mikolajcebula/chwytak-robot/Raport.pdf

## Projekt chwytaka do robota FANUK M-10iA

Mikołaj Cebula
Numer albumu 304486

prowadzący
Grzegorz Kamiński

6 grudnia 2021

## Spis treści

1 Wstęp | 2
2 Kinematyka mechanizmu | 2
3 Wyznaczenie siły chwytu chwytaka | 4
4 Dobór siłownika | 5
5 Dobór śrub pasowych | 8
6 Dobór łożysk | 13
7 Podsumowanie | 15

1

2 KINEMATYKA MECHANIZMU

## 1 Wstęp

Projekt polegał na zaprojektowaniu oraz wykonanie dokumentacji technicznej chwytaka do robota FANUC M-10iA. Ma on za zadanie przenoszenie okrągłych elementów o średnicy od 55 do 77 mm. Dodatkowo zakłądam, że ciężar przedmiotu nie przekroczy 43 N.

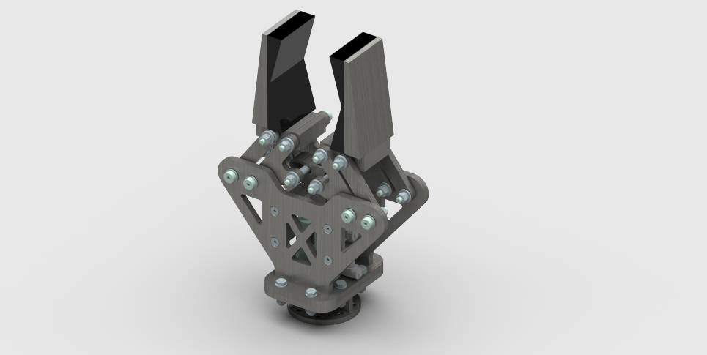
[picture p1: figure]

Rysunek 1: Wizualizacja gotowego projektu.

Jako napęd zastosowany zostanie siłownik pneulatyczny, którgo parametry zostaną dobrane w dalszym etapie projektu.

## 2 Kinematyka mechanizmu

Pierwszym krokiem w realizacji było oblicznie liczby stopni swobody. Z uwagi na ruch chwytaka w jednej płaszczyźnie, skorzystano z uproszczonego wzoru Grublera [1]:

w = 3 ∗ n − p4 − 2 ∗ p5

n - liczba elementów, p4 - liczba par 4 klasy, p5- liczba par 5 klasy

Poniższe zdjęcię ostatecznego modelu prezentuje liczbę elementów oraz par kinematycznych.

2

2 KINEMATYKA MECHANIZMU

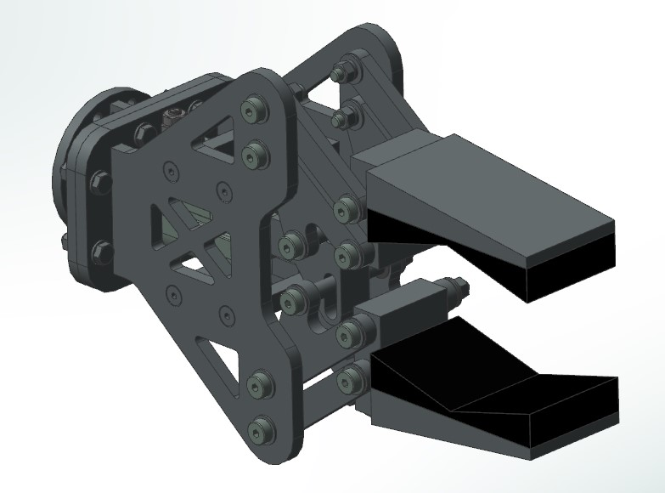
[picture p2: figure]

Rysunek 2: Wizualizacja liczby elementów i par kinematycznych modelu.

Układ kinematyczny składa się z:

| popychacza
| 4 cięgien L
| 4 cięgien prostych
| 2 chwytników

Więc układ złożony jest z 11 ogniw. Nie posiada par kinematycznych 4 klasy, natomiast składa się z 16 par kinematycznych 5 klasy (4 pary postępowe i 12 obrotowych).

w = 3 ∗ 11 − 2 ∗ 16 = 1

Z obliczeń wynika, że mechanizm chwytaka ma 1 stopień swobody.

3

3 WYZNACZENIE SIŁY CHWYTU CHWYTAKA

## 3 Wyznaczenie siły chwytu chwytaka

Siłę chwytu można wyznacza się za pomocą wzoru:

Fch = 2 ∗ N ∗ cos(90◦ − γ)

Gdzie poszczególne oznaczenia przedstawiono na schemacie:

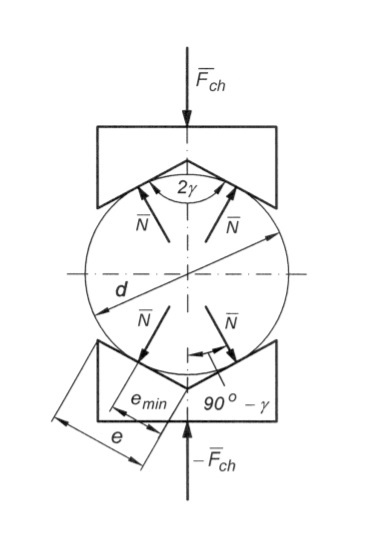
[picture p3: figure]

Rysunek 3: Rozkład sił normalnyh podczas chwytania obiektu.

4

4 DOBÓR SIŁOWNIKA

Współczynnik tarcia między metalem, a gumą wynosi η = 1 [2]. Natomiast współczynnik przeciążenia chwytaka przyjęto n=2. Z powodu okrągłego kształty przenoszonego przedmioty kąt pomiędzy gumowymi okładzinami wynosi γ = 150◦
T = N ∗ η = Fc ∗ η = Fc

Fch =

Fc ∗ n ∗ cos(90◦ − γ)
2 ∗ η

= Fc ∗ cos(90◦ − γ)

Fch = 41, 5N

## 4 Dobór siłownika

W tym kroku wyliczono siłę potrzeną do zamknięcia chwytaka. Na jej podstawie, dobrano odpowiedni siłownik z katalogu firmy Festo [3]. Aby wykonać to zadanie należy sprowadzić mechanizm do niżej pokazanego schematu, wyliczyć reakcje oraz siłę siłownika w zakresie pracy chwytaka [1].

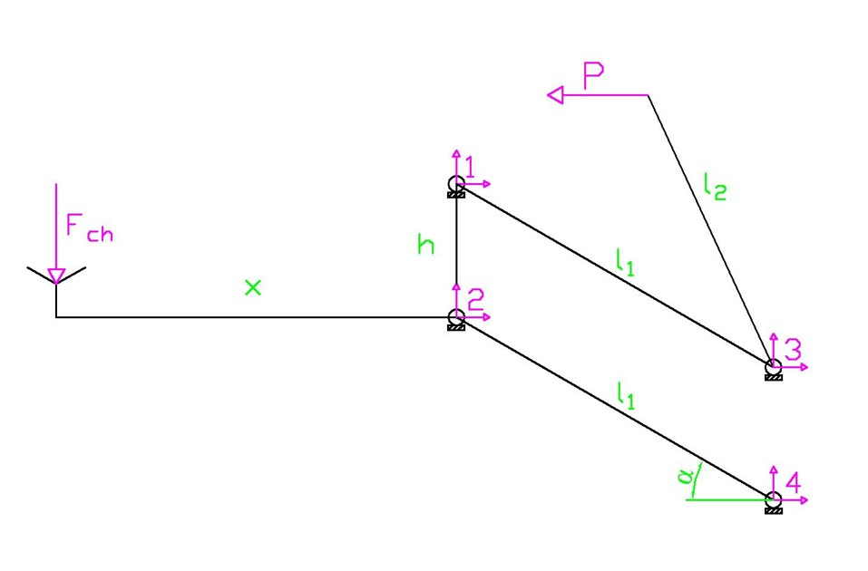
[picture p4: figure]

Rysunek 4: Schemat kinematyczny

5

4 DOBÓR SIŁOWNIKA

Na podstawie powyższego schematu, można zapisać następujące równania:

F1x + F2x = 0 | (1)
F1y + F2y − Fch = 0 | (2)
Fch ∗ x + F1x ∗ h = 0 | (3)
F2x + F4x = 0 | (4)
F2y + F4y = 0 | (5)
F2x ∗ l1 ∗ sin(α) + F2y ∗ l1 ∗ cos(α) = 0 | (6)
F1x + F3x = 0 | (7)
F1x + F3y = 0 | (8)
R1x ∗ l2 ∗ sin(α) + R1y ∗ l2 ∗ cos(α) − P ∗ l2 ∗ sin(α − 35) = 0 | (9)

Za pomocą gotowego złożenia został odczytany kąt alfa. Jego zakres wynosi:

αmin = 34, 9

◦

αmax = 50, 6

◦

6

4 DOBÓR SIŁOWNIKA

Po rozwiązaniu powyższego układu równań w podanym zakresie kąta alfa otrzymano następujące wyniki:

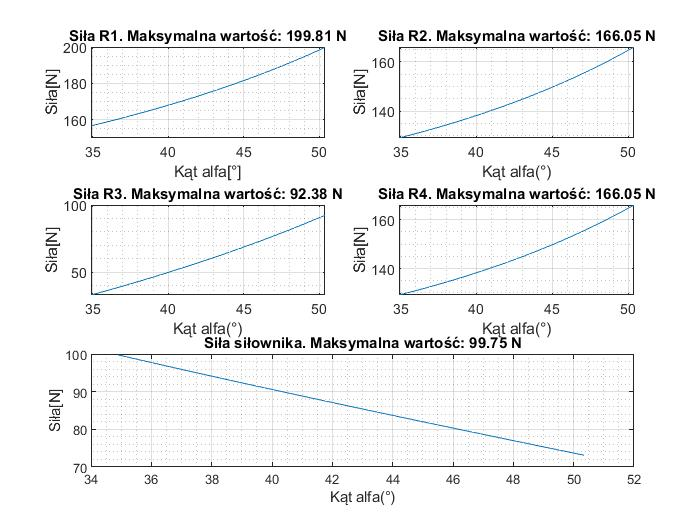
[picture p5: figure]

Rysunek 5: Rozkład poszczególnych reakcji

Można zaobserwować, że siły w przegubach rosną wraz z zwiększaniem kąta, natomiast siła pochodząca od siłownika maleje. Wyliczone reakcje przegubów wykorzystane zostaną podczas doboru śrub pasowych i łożysk ślizgowych. Maksymalna siła jaką musi wygenerować siłownik wynosi 100 N. Na tej podstawie siłownik ADN-20-15-PPS-A [3].

7

5 DOBÓR ŚRUB PASOWYCH

## 5 Dobór śrub pasowych

Wyboru śrub pasowanych dokonano na podstawie obliczeń wytrzymałościowych. Na potrzeby obliczeń śrubę zamodelowano jako zginaną belkę. Obliczenia zotały wykonane za pomocą metod wytrzymałości konstrukcji [4]. Na poniższym schemacie zaznaczono podpory oraz siły działające na modelowaną bęlkę:

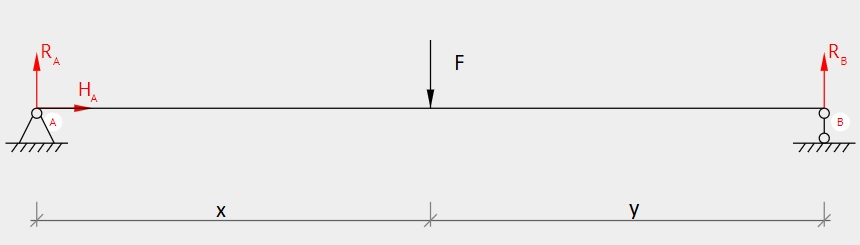
[picture p6: figure]

Rysunek 6: Schemat podparcia i obciążenia śrub

Wyboru śrub dokonujemy na podstawie wyniku obliczeń, w których porównujemy naprężenia zredukowane z wpółczynnikiem wytrzymałości na rozciąganie elementów stalowych. Jest on równy 0.45*granica wytrzymałości na rozciąganie (Rm). Naprężenia zredukowane obliczamy następująco:

σ =

Mg ∗ d
2 ∗ J

(10)

τ =

4 ∗ T
3 ∗ A

(11)

J =

π ∗ d

4

64

(12)

A =

π ∗ d

2

4

(13)

σred =

p
σ

2 + 3 ∗ τ

2 ← 0.45 ∗ Rm | (14)
s
(

32 ∗ Mg
π ∗ d

3

)

2 + 3 ∗ (

16 ∗ T
3 ∗ π ∗ d

2

)

2 ← 0.45 ∗ Rm | (15)

Według katalogu producenta Rm wynosi 1200 MPa. Do wyznaczenia rozkładu momentu gnącego oraz siły tnącej wykorzystano kalkulator internetowy Beamguru [5].

8

5.1 Śruba pierwsza | 5 DOBÓR ŚRUB PASOWYCH

Oznaczenia przegubów są zgodne z oznaczeniami ze schematy kinematycznego.

### 5.1 Śruba pierwsza

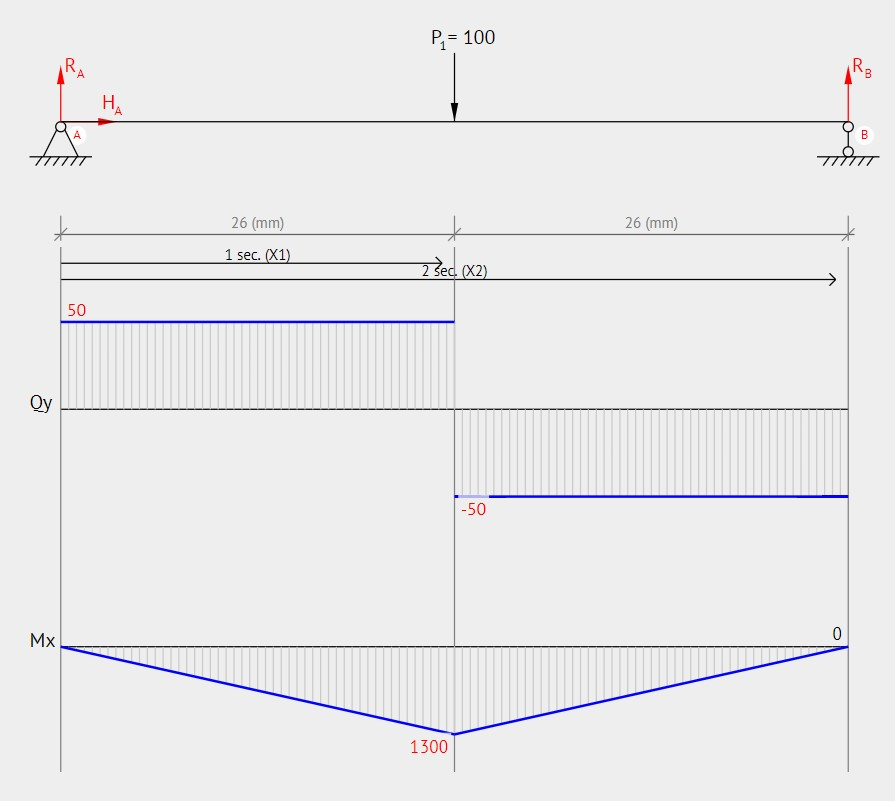
[picture p7: figure]

Rysunek 7: Rozkład obciążeń dla śruby numer 1

Śruba nr 1 obciążona jest w połowie długiści, więc x = y = 26 mm. Po obliczeniu równania (15), otrzymano następujący wynik: d1 = 2, 9 mm

9

5.2 Śruba druga | 5 DOBÓR ŚRUB PASOWYCH

### 5.2 Śruba druga

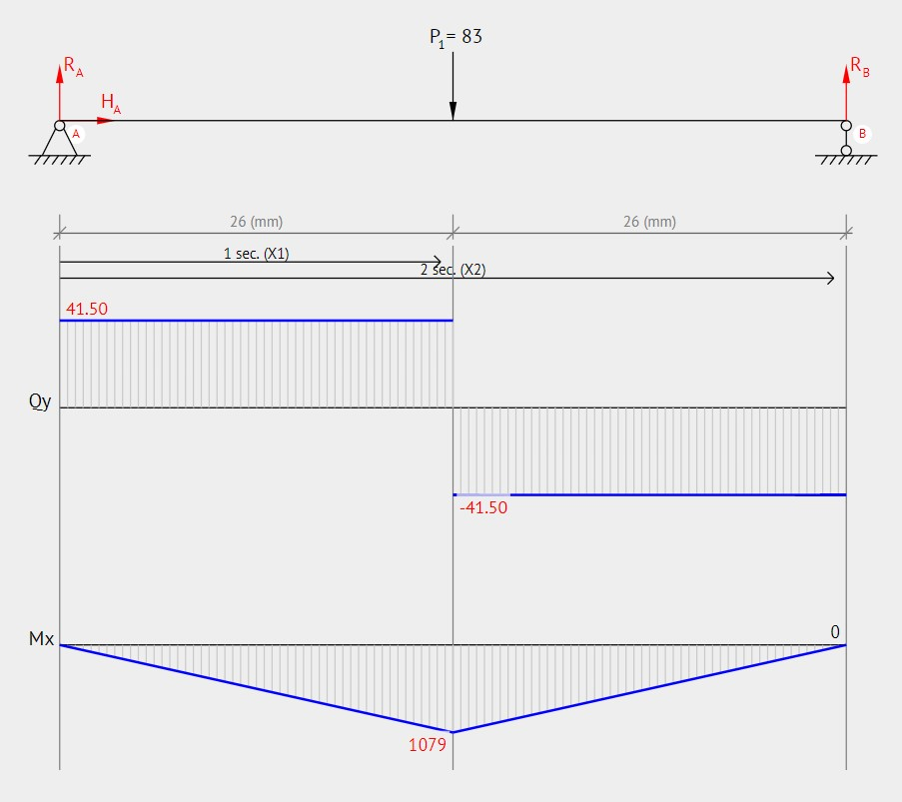
[picture p8: figure]

Rysunek 8: Rozkład obciążeń dla śruby numer 2

Śruba nr 2 obciążona jest w połowie długiści, więc x = y = 26 mm. Po obliczeniu równania (15), otrzymano następujący wynik: d2 = 2, 7 mm

10

5.3 Śruba trzecia | 5 DOBÓR ŚRUB PASOWYCH

### 5.3 Śruba trzecia

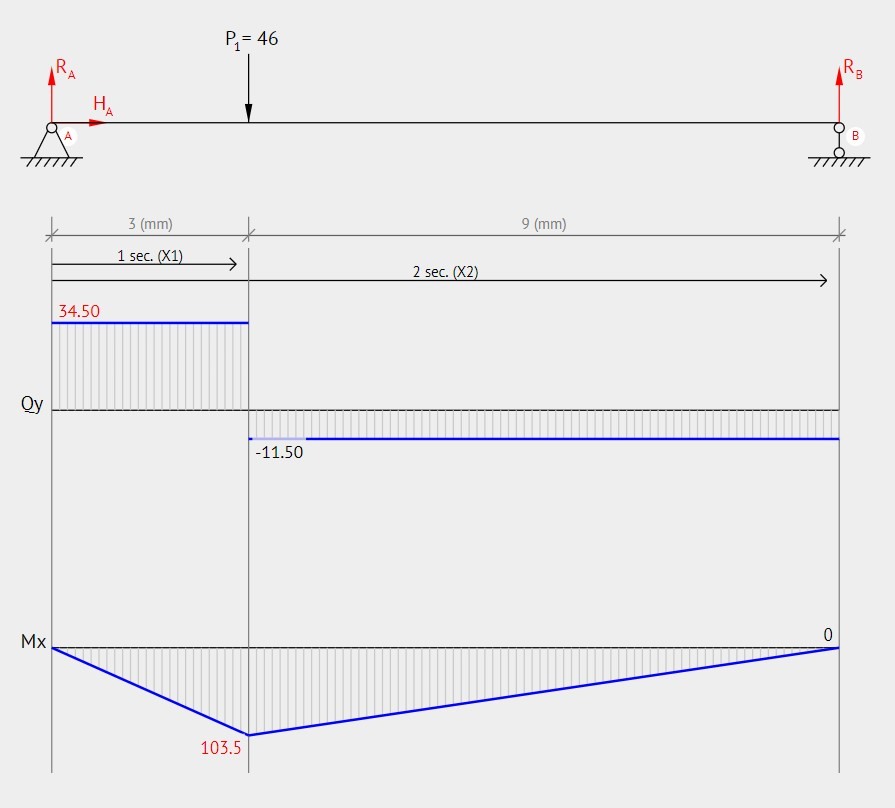
[picture p9: figure]

Rysunek 9: Rozkład obciążeń dla śruby numer 3

Dla śruby nr 3 x = 3 mm, a y = 9 mm. Po obliczeniu równania (15), otrzymano następujący wynik: d3 = 1, 3 mm

11

5.4 Śruba czwarta | 5 DOBÓR ŚRUB PASOWYCH

### 5.4 Śruba czwarta

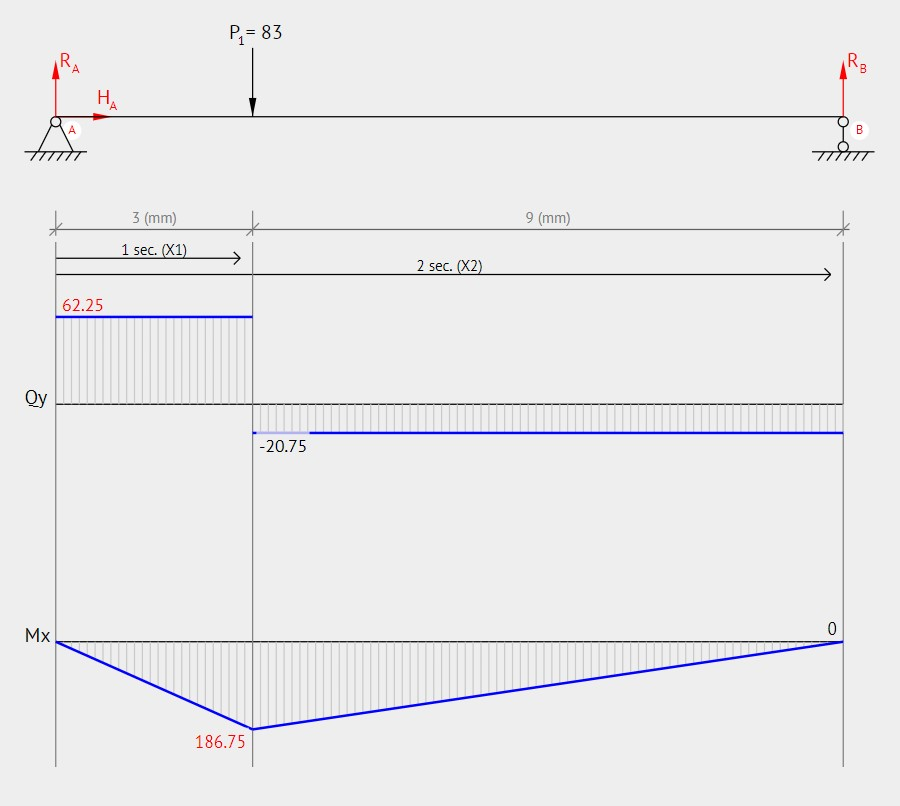
[picture p10: figure]

Rysunek 10: Rozkład obciążeń dla śruby numer 4

Dla śruby nr 4 x = 3 mm, a y = 9 mm. Po obliczeniu równania (15), otrzymano następujący wynik: d4 = 1, 5 mm

### 5.5 Wnioski

Z powyższych wyników (4.1, 4.2, 4.3, 4.4) wynika, że maksymalna średnica wynosi 2,9mm. Oznacza to, że minimalna średnica śruby jaką można zastosować jest równa 3mm. W naszym projekcie w celu zapewnienia odpowiedniego zapasu bezpieczeństwa zastosowano śruby o średnicy d = 6mm [6].

12

6 DOBÓR ŁOŻYSK

## 6 Dobór łożysk

Następnym krokiem będzie dobór łożysk ślizgowych. Naszym kryterium wyboru będzie maksymalny nacisk powierzchniowy, jaki wytrzymuje łożysko. Do obliczenia nacisku działającego na łożysko posłuży nam poniższy wzór [7]:
P =

F
d1∗b1

F-obciążenie [N], d1-śr. wewnętrzna łożyska, b1-dl. powierzchni łożyskowanej

Łożyska musi współgrać z śrubą pasową dobraną w poprzednim rozdziale, więc użyte zostaną o śr. wewnętrznej równej 6 mm. Wyniki obliczeń wytrzymałościowych porównane zostaną z danymi technicznymi podamnymi przez producenta.

Oznaczenia przegubów są zgodne z oznaczeniami ze schematu kinematycznego.

### 6.1 Przegub numer 1

Przegub nr 1 składa się z ramienia oraz chwytnika. W każdym ramieniu zastosowane zostaną dwie tuleje z kołnierzami o długości 2,9 mm, natomiast w chwytniku dwie tuleje z kołnierzami o długości 10 mm oraz jedna tuleje o długości 17,5 mm.

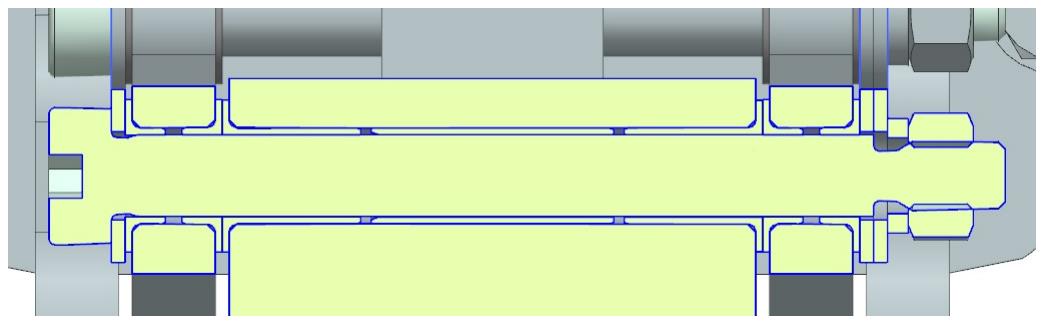
[picture p11: figure]

Rysunek 11: Łożyskowanie przegubu nr 1

PRamie = 2, 9 MPa
PChwytnik = 0, 9 MPa

13

6.2 Przegub numer 2 | 6 DOBÓR ŁOŻYSK

### 6.2 Przegub numer 2

W przegubie nr 2 postępowano analogicznie jak podczas łożyskowania przegubu 1.

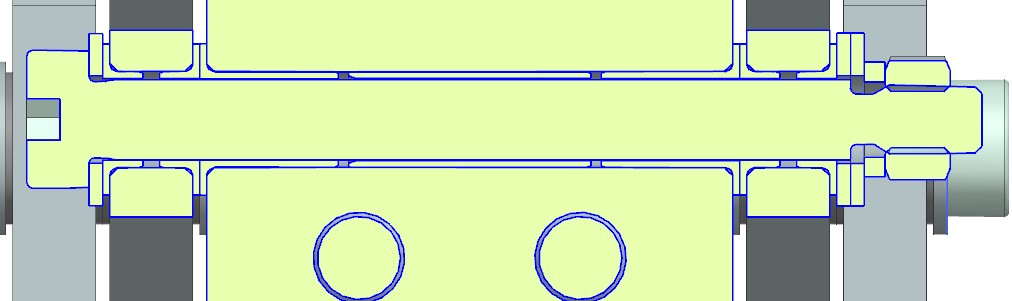
[picture p12: figure]

Rysunek 12: Łożyskowanie przegubu nr 2

PRamie = 2, 4 MPa
PChwytnik = 0, 7 MPa

### 6.3 Przegub numer 3

Natomiast w przegubie nr 3 zastosowano po dwa łożyska o długości 2,9 mm na każde ramię oraz ścianę korpusu.

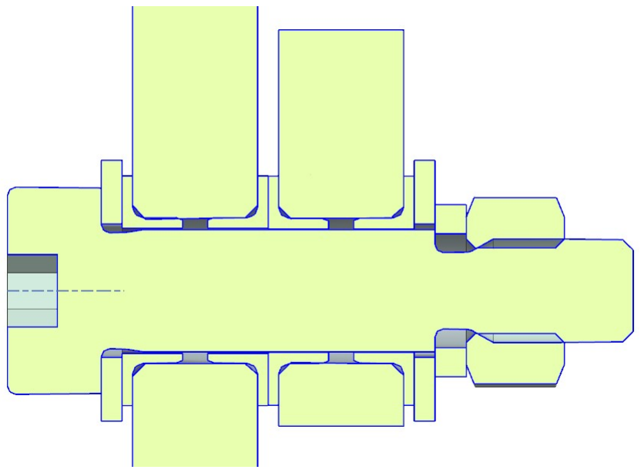
[picture p13: figure]

Rysunek 13: Łożyskowanie przegubu nr 3

PRamie = 1, 3 MPa

14

6.4 Przegub numer 4 | 7 PODSUMOWANIE

PKorpus = 1, 3 MPa

### 6.4 Przegub numer 4

W przegubie nr 4 postępowano analogicznie ak podczas łożyskowania przegubu 3.

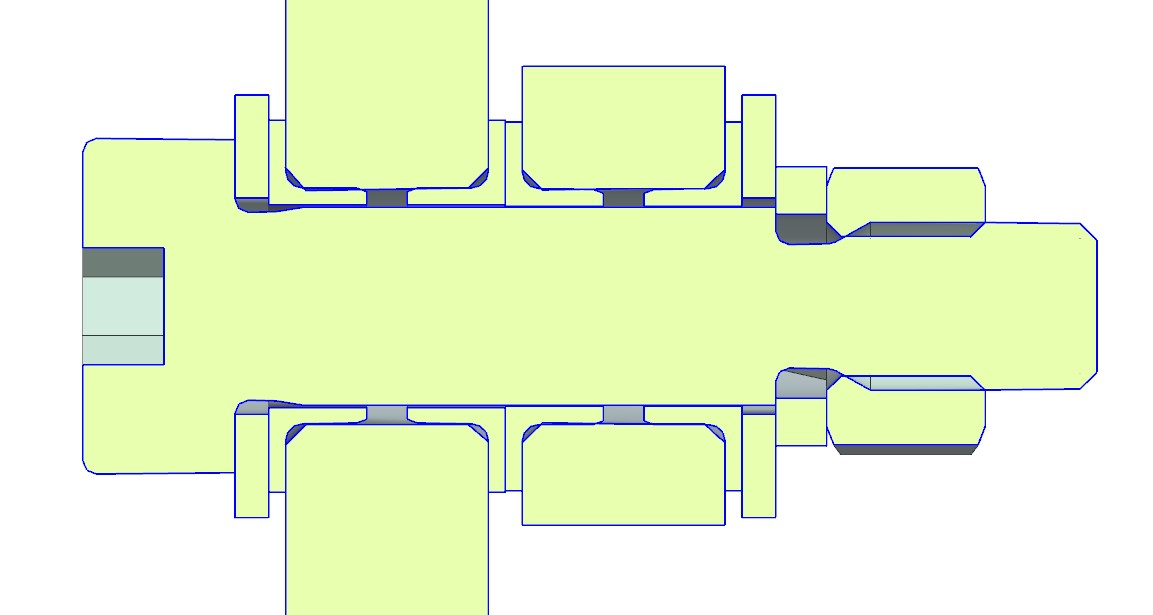
[picture p14: figure]

Rysunek 14: Łożyskowanie przegubu nr 4

PRamie = 2, 4 MPa
PKorpus = 2, 4 MPa

### 6.5 Wnioski

Porównując powyższe wyniki z danymi producenta można wywnioskować, że otrzymane naprężenia są wielkokrotnie mniejsze od dopuszczalnych nacisków. Dzięki temu mamy pewność, że zastosowane łożyska będą pracować prawidłowo.

## 7 Podsumowanie

Celem projektu było zaprojektowanie chwytaka do robota FANUC M-10iA. Niniejszy raport prezentuje konieczne obliczenia wytrzymałościowe, kinematyki mechanizmu oraz zakres ruchomości. Na podstawie powyższych wyników można wywnioskować, że chwytak został zaprojektowany poprawnie. Do raportu dołączona została dokumentacja techniczna, składająca się

15

7 PODSUMOWANIE

z rysunków technicznych wybranych części oraz rysunków złożeniowych elementu łączącego chwytak do robota i całego chwytaka [8]. Nie brakuje jednak elementów, które można wykonać w lepiej.

Jednym z nich jest optymalizacja masy chwytaka. Powinnien być on jak najlżejszy, aby zminimalizować obciążenie robota, który będzie wyposażony w zaprojektowaną część. Optymalizacji można poddać, np. chwytniki, tuleje łączącą chwytak z robotem.

Następnym aspektem, który można poprawić są wymiary geometryczne odpowiadające za rozwarcie chwytaka. Dzięki tej operacji można zmniejszyć siły występujące na złączach oraz siłę generowaną przez siłownik.

Można również rozważyć wykorzystanie innego matreriału oraz technologii wykonania poszczególnych elementów chwytka. Dzięki takim działaniu moglibyśmy zmniejszyć masę oraz cenę.

16

7 PODSUMOWANIE

## Bibliografia

1. J. Frączek, M.Wojtyra, Wykład z Teorii Maszyn i Mechanizmów.
2. Współczynnik tarcia https://pl.wikipedia.org/wiki/Wsp%C3%B3%C5 %82czynnik tarcia
3. Compact cylinders ADN/AEN, to ISO 21287 https://www.festo.com/cat/engb gb/data/doc engb/PDF/EN/ADN EN.PDF
4. Z. Brzoska,Wytrzymałość materiałów.Warszawa: Wydawnictwo Naukowe PWN, 1983.
5. Internetowy kalkulator belek https://beamguru.com/online/beam-calculator/
6. Specyfikacja śrub pasowanych ISO 7379 https://www.elesa-ganter.pl/siteassets/PDF/PL/ISO%207379.pdf
7. Obciążenie łożysk https://www.igus.pl/info/plain-bearings-iglidur-load
8. T. Dobrzański, Rysunek Techniczny Maszynowy.Warszawa: Wydawnictwo Naukowe PWN, 2004.

17
