mikolajcebula/chwytak-robot/rysunki/CHMC-000-00.pdf

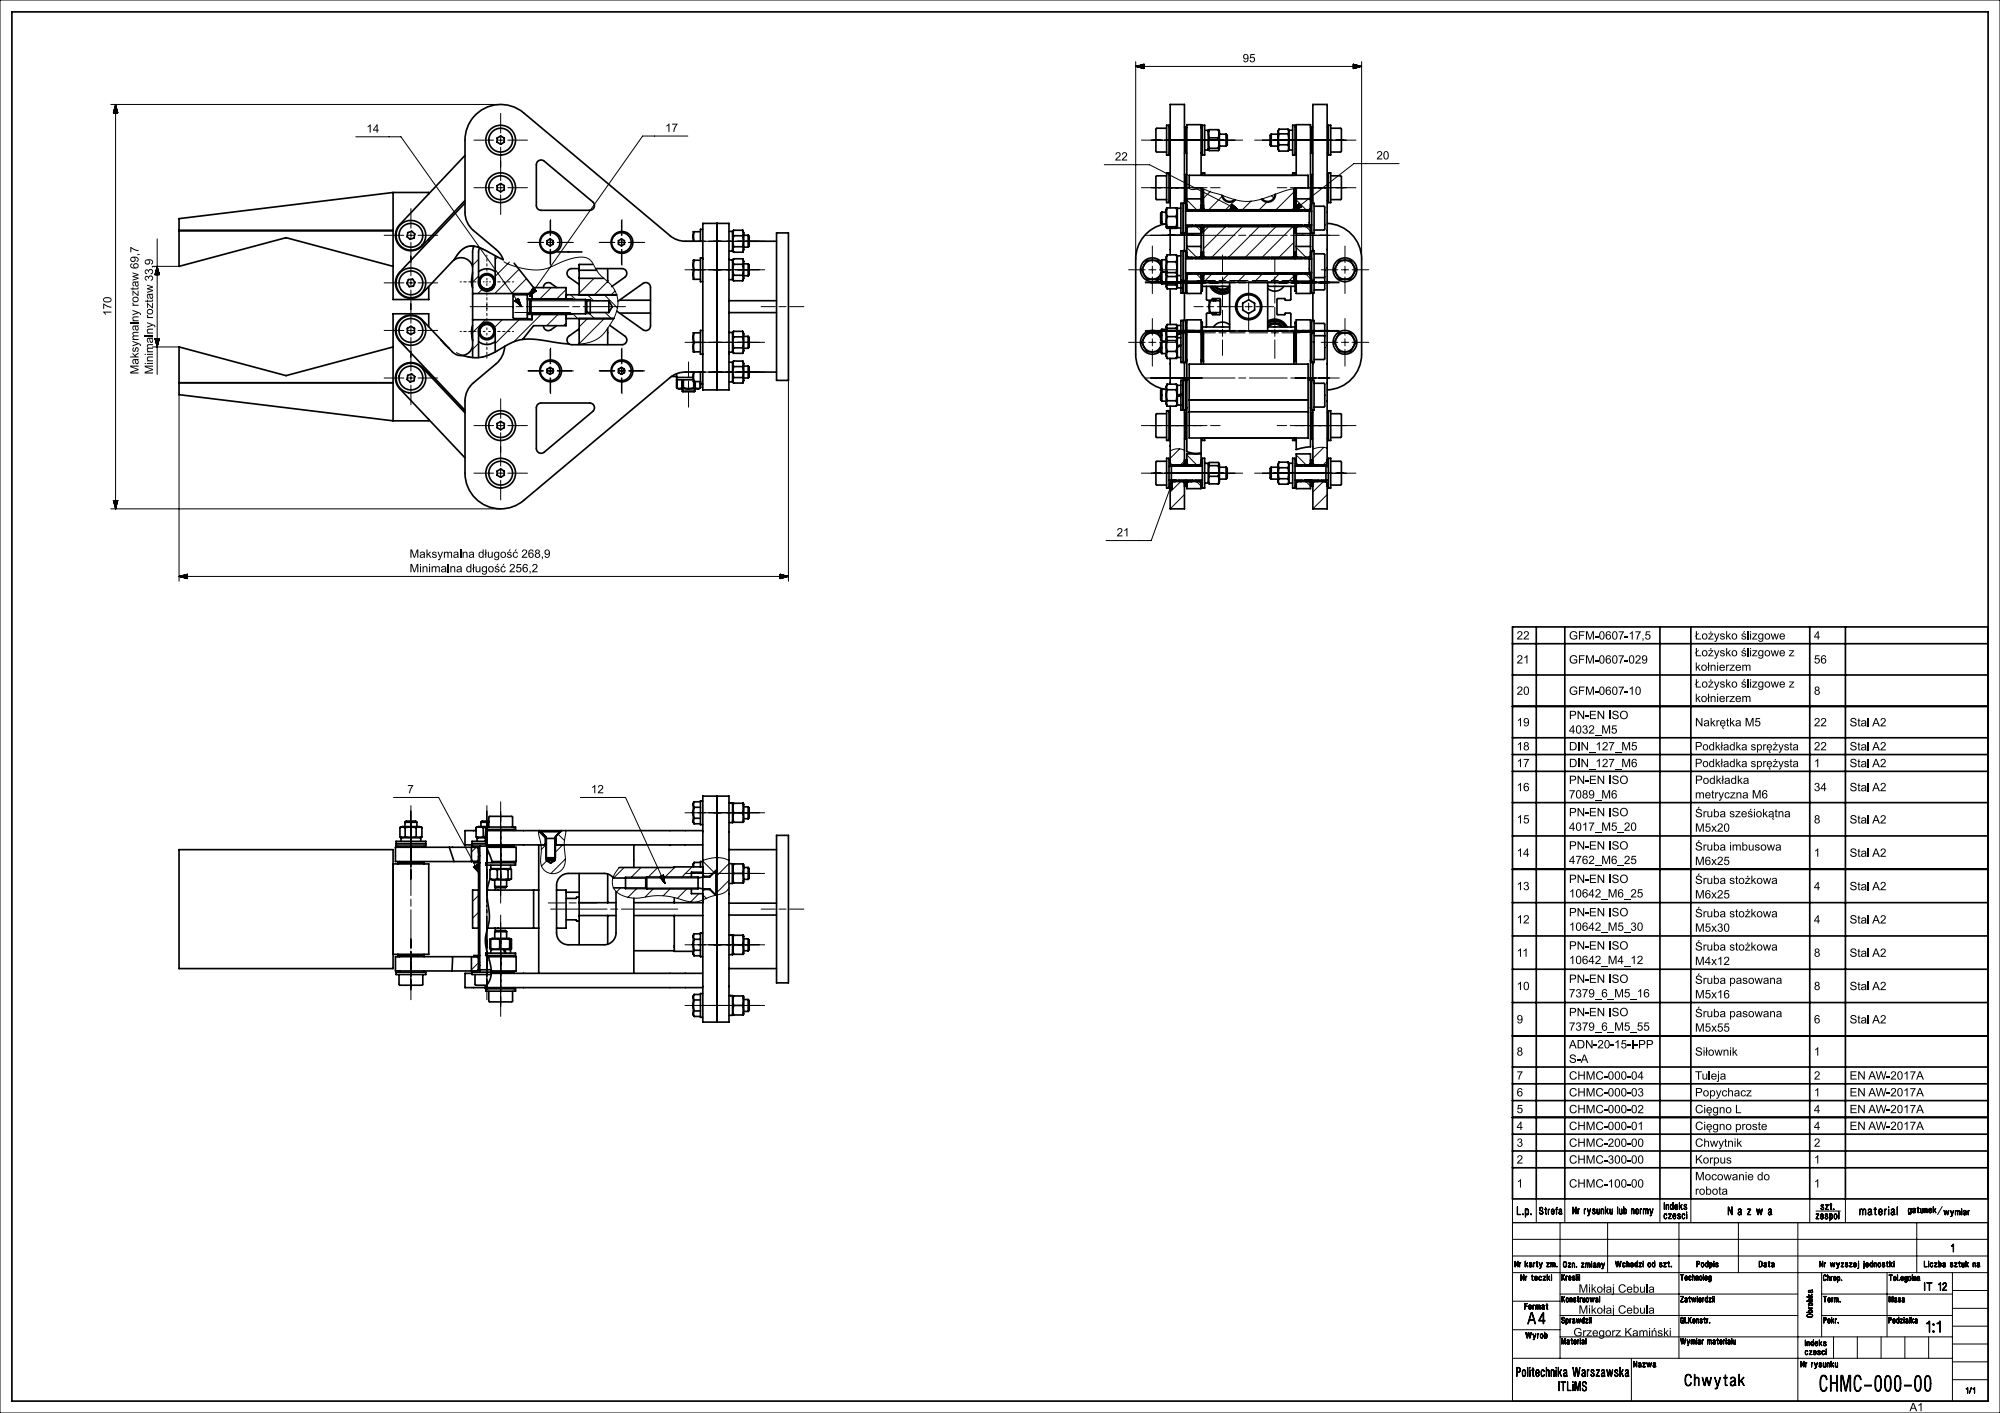
[picture p16: page 1]
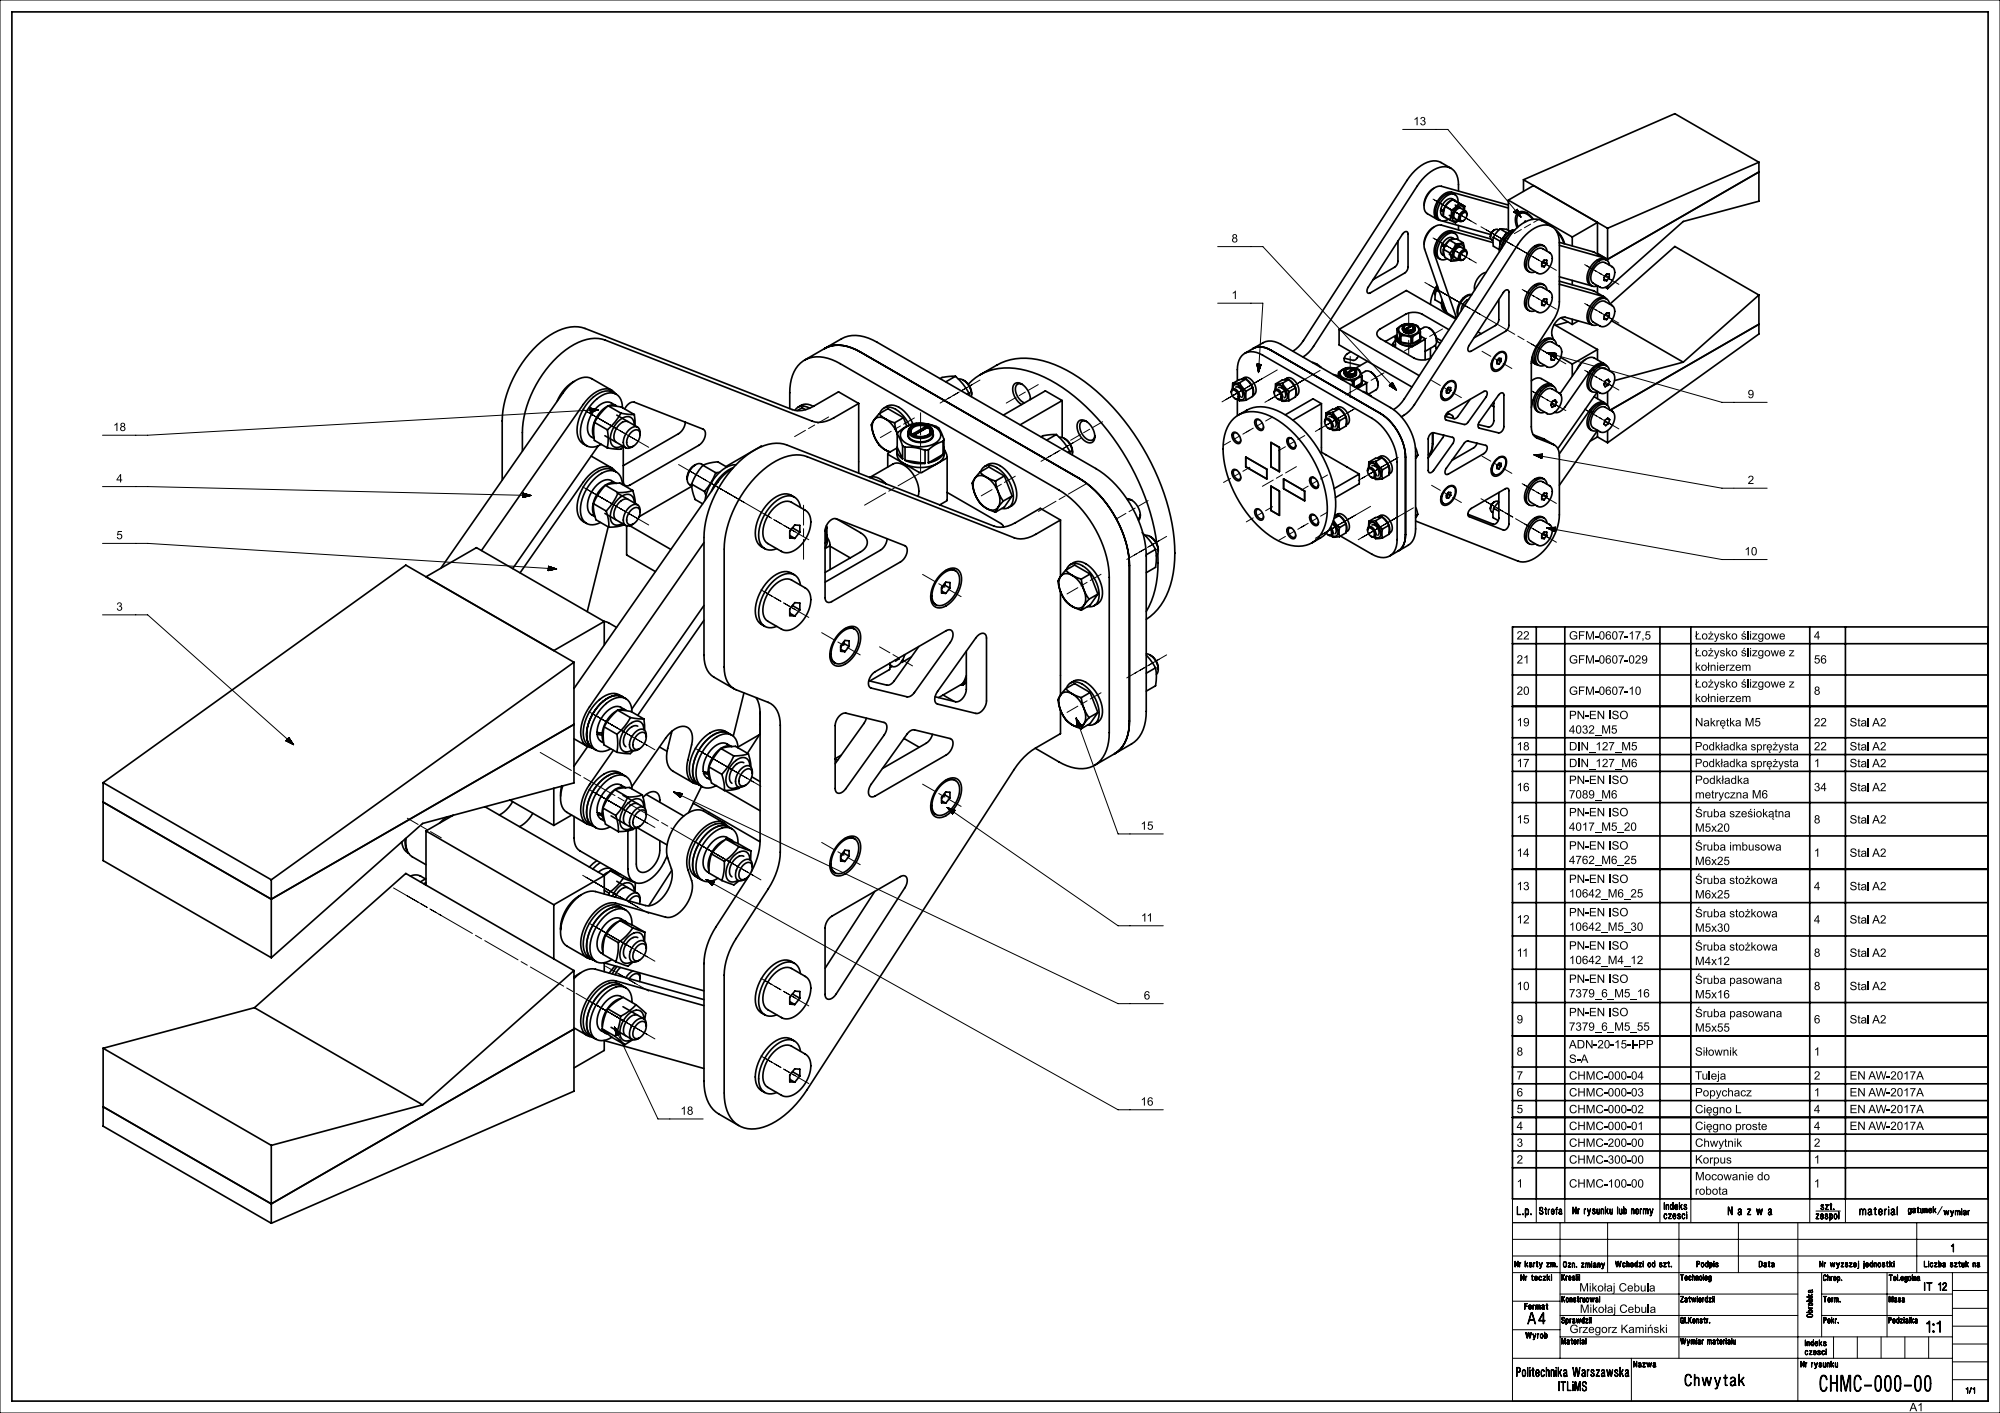
[picture p17: page 2]
