mikolajcebula/chwytak-robot/rysunki/CHMC-100-00.pdf

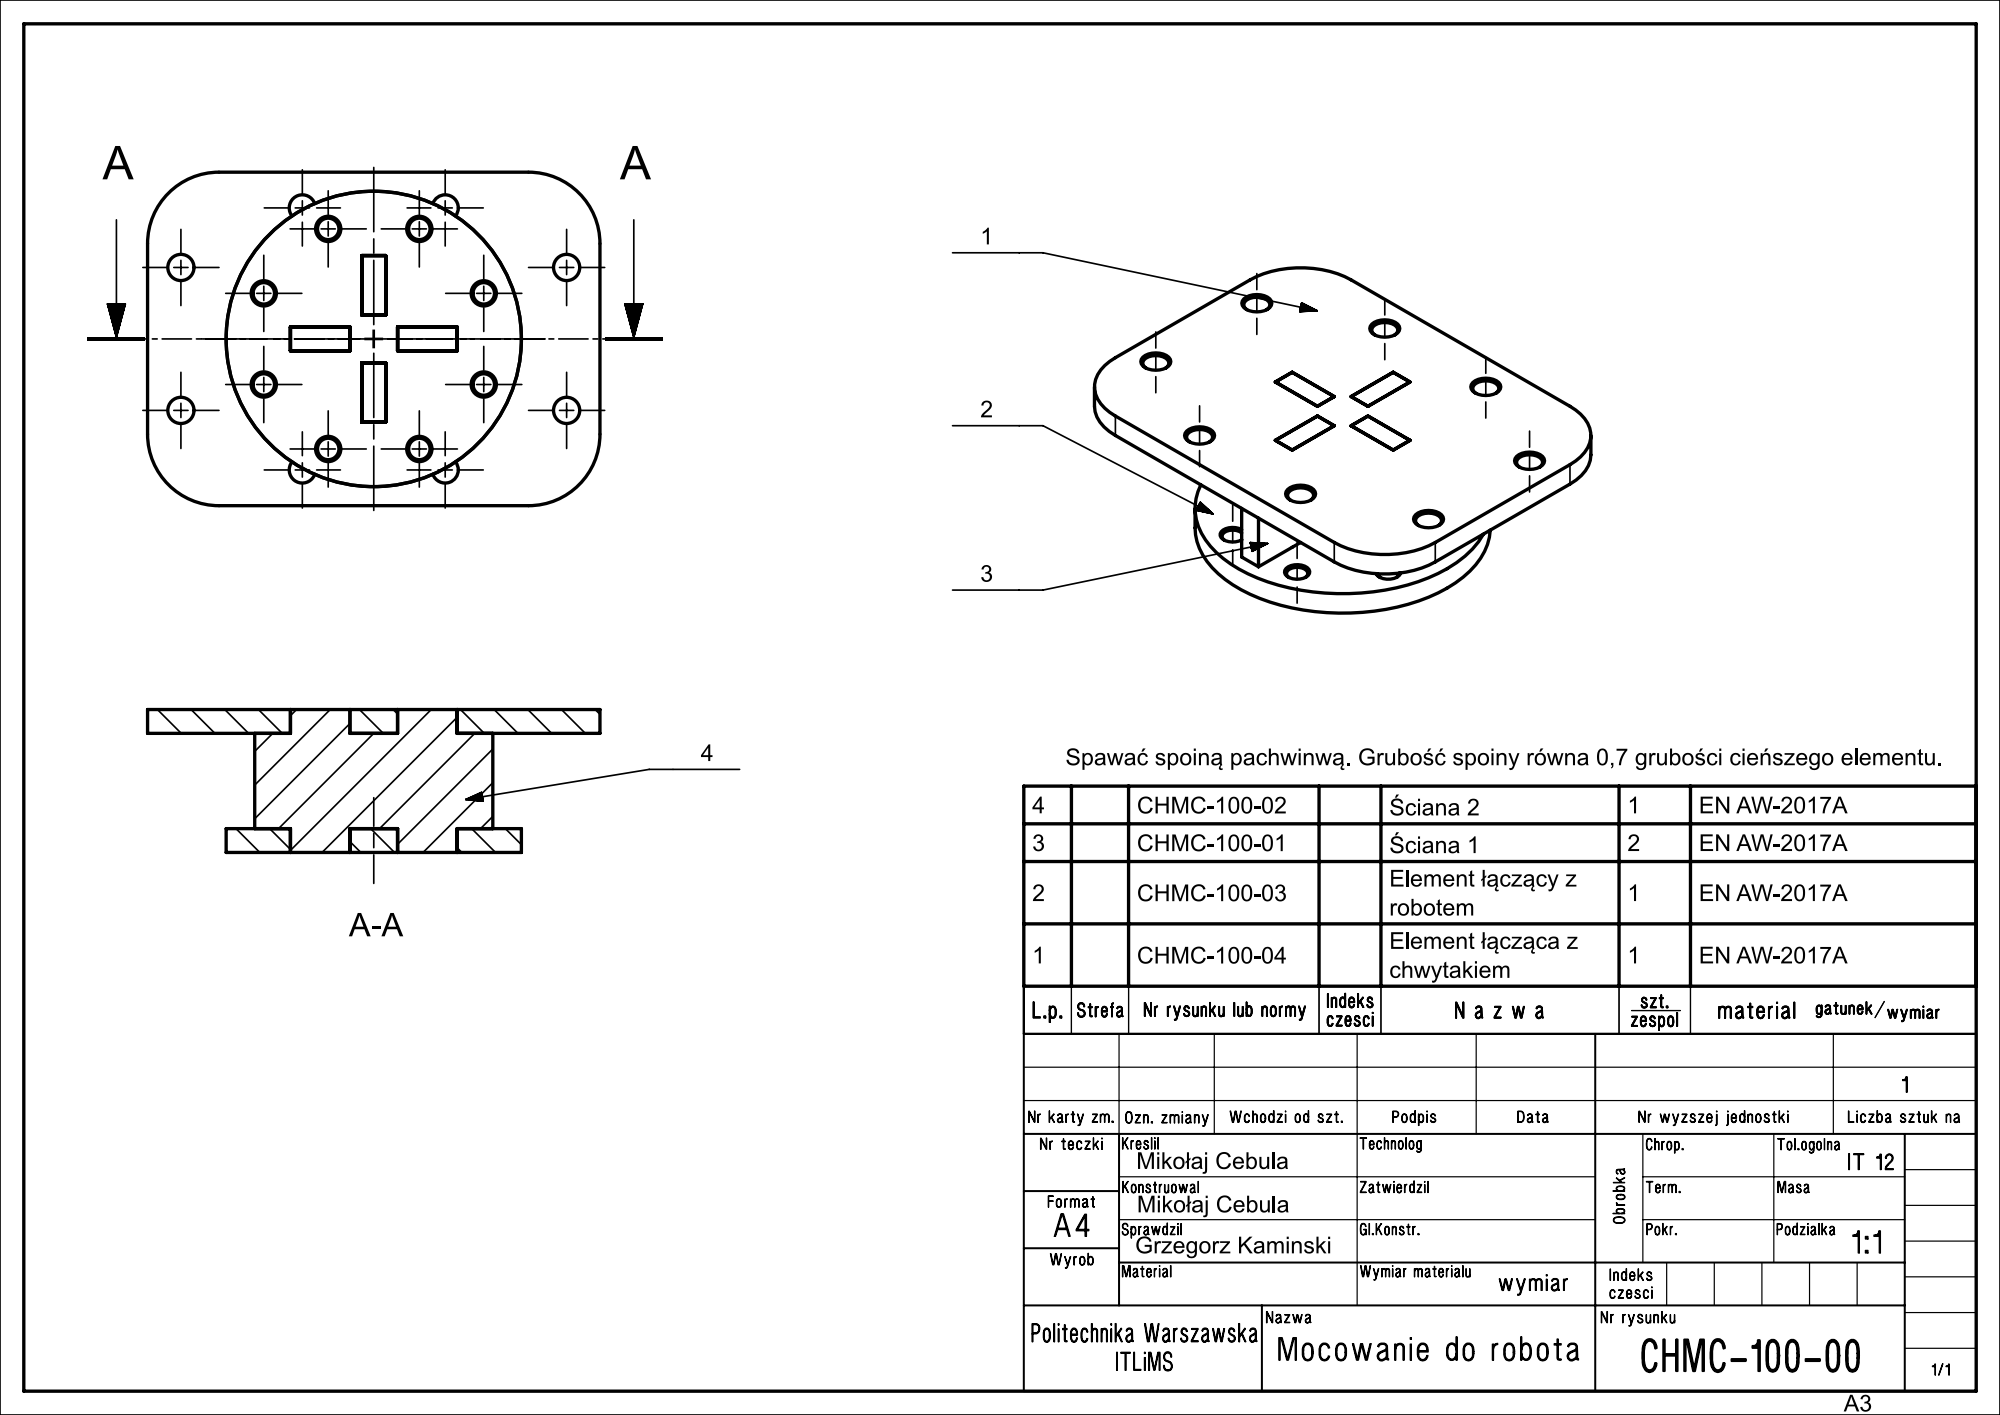
[picture p18: page 1]
