mikolajcebula/chwytak-robot/rysunki/CHMC-100-01.pdf

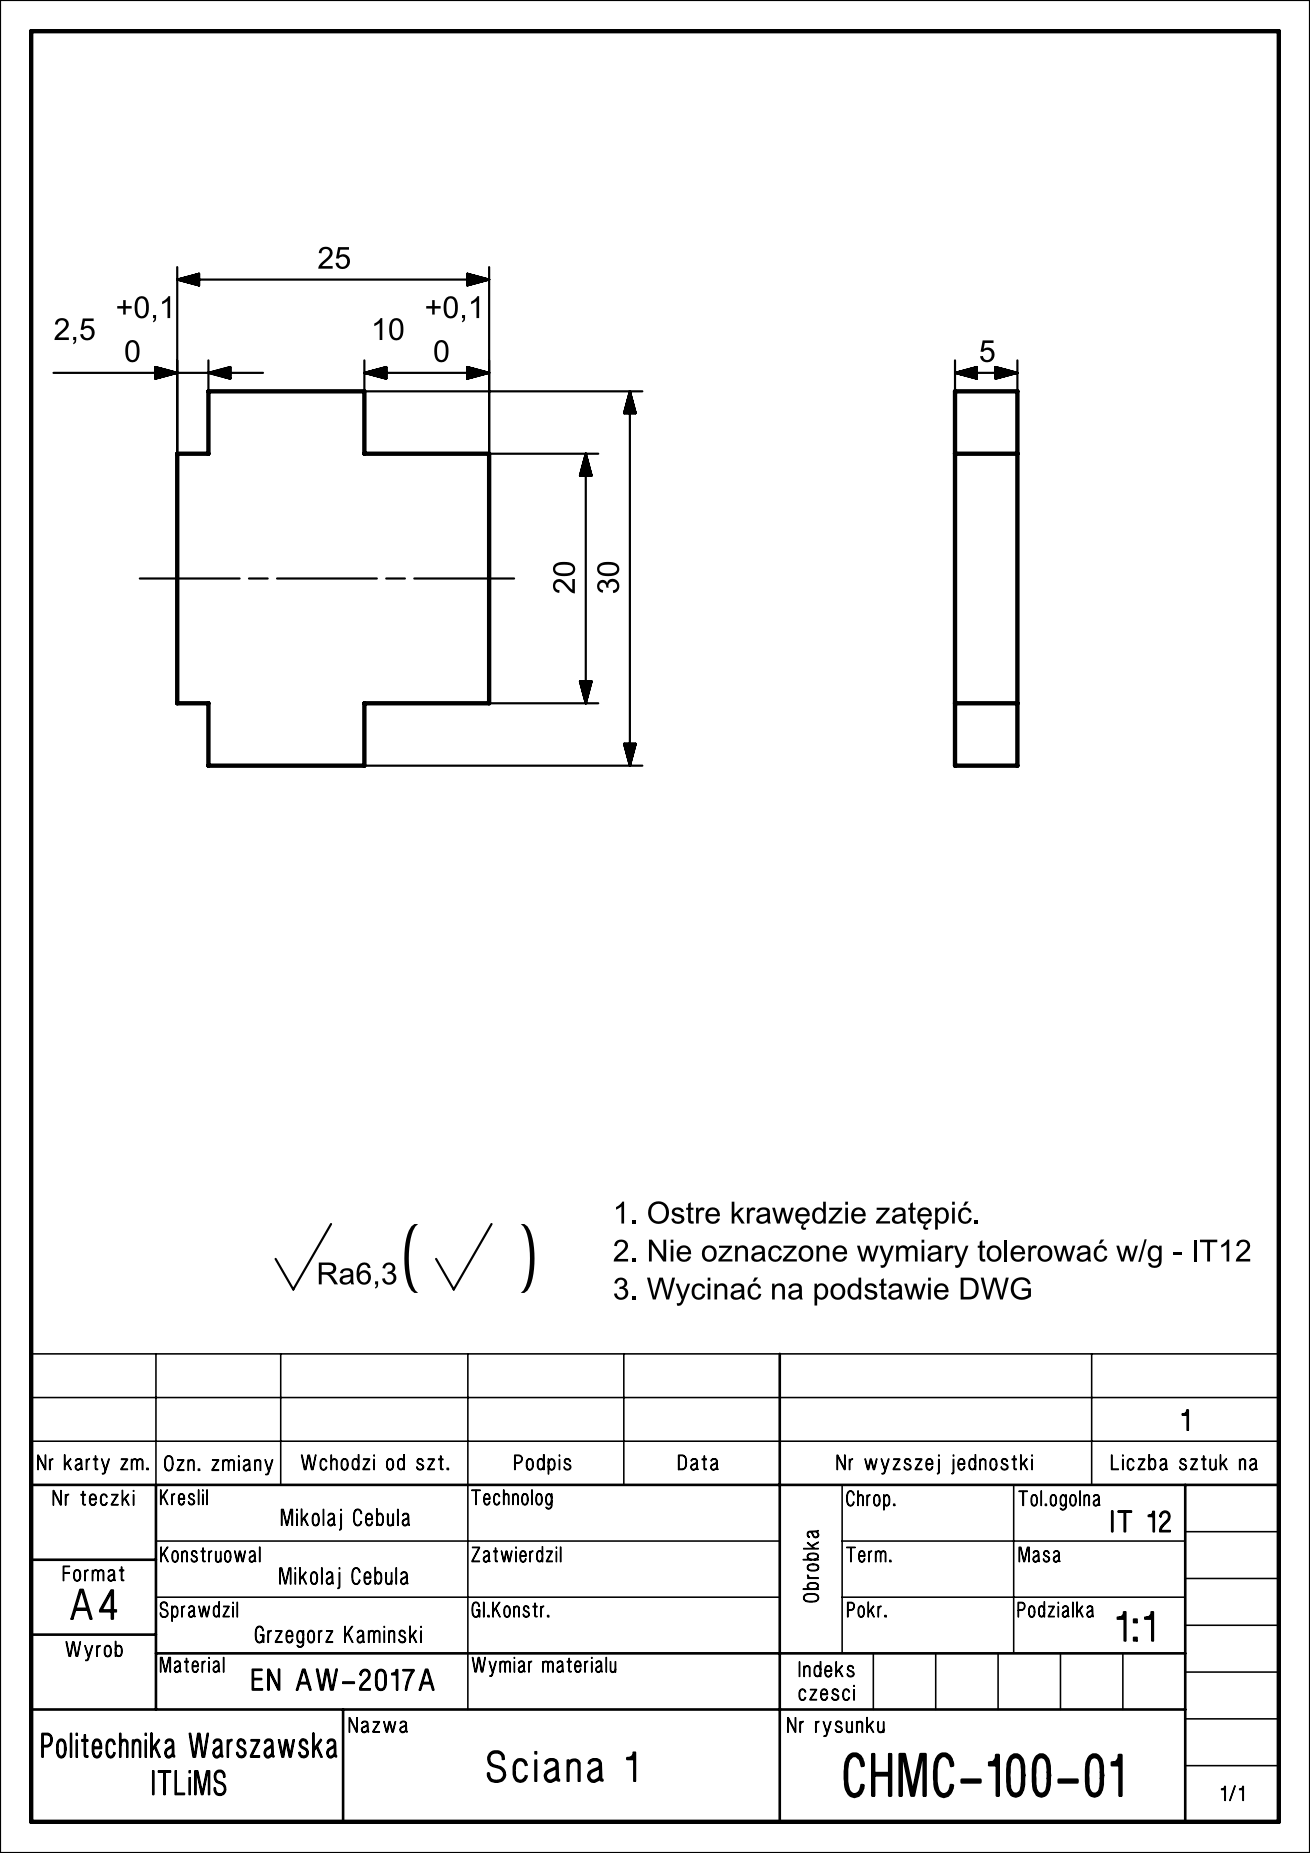
[picture p19: page 1]
