mikolajcebula/chwytak-robot/rysunki/CHMC-100-02.pdf

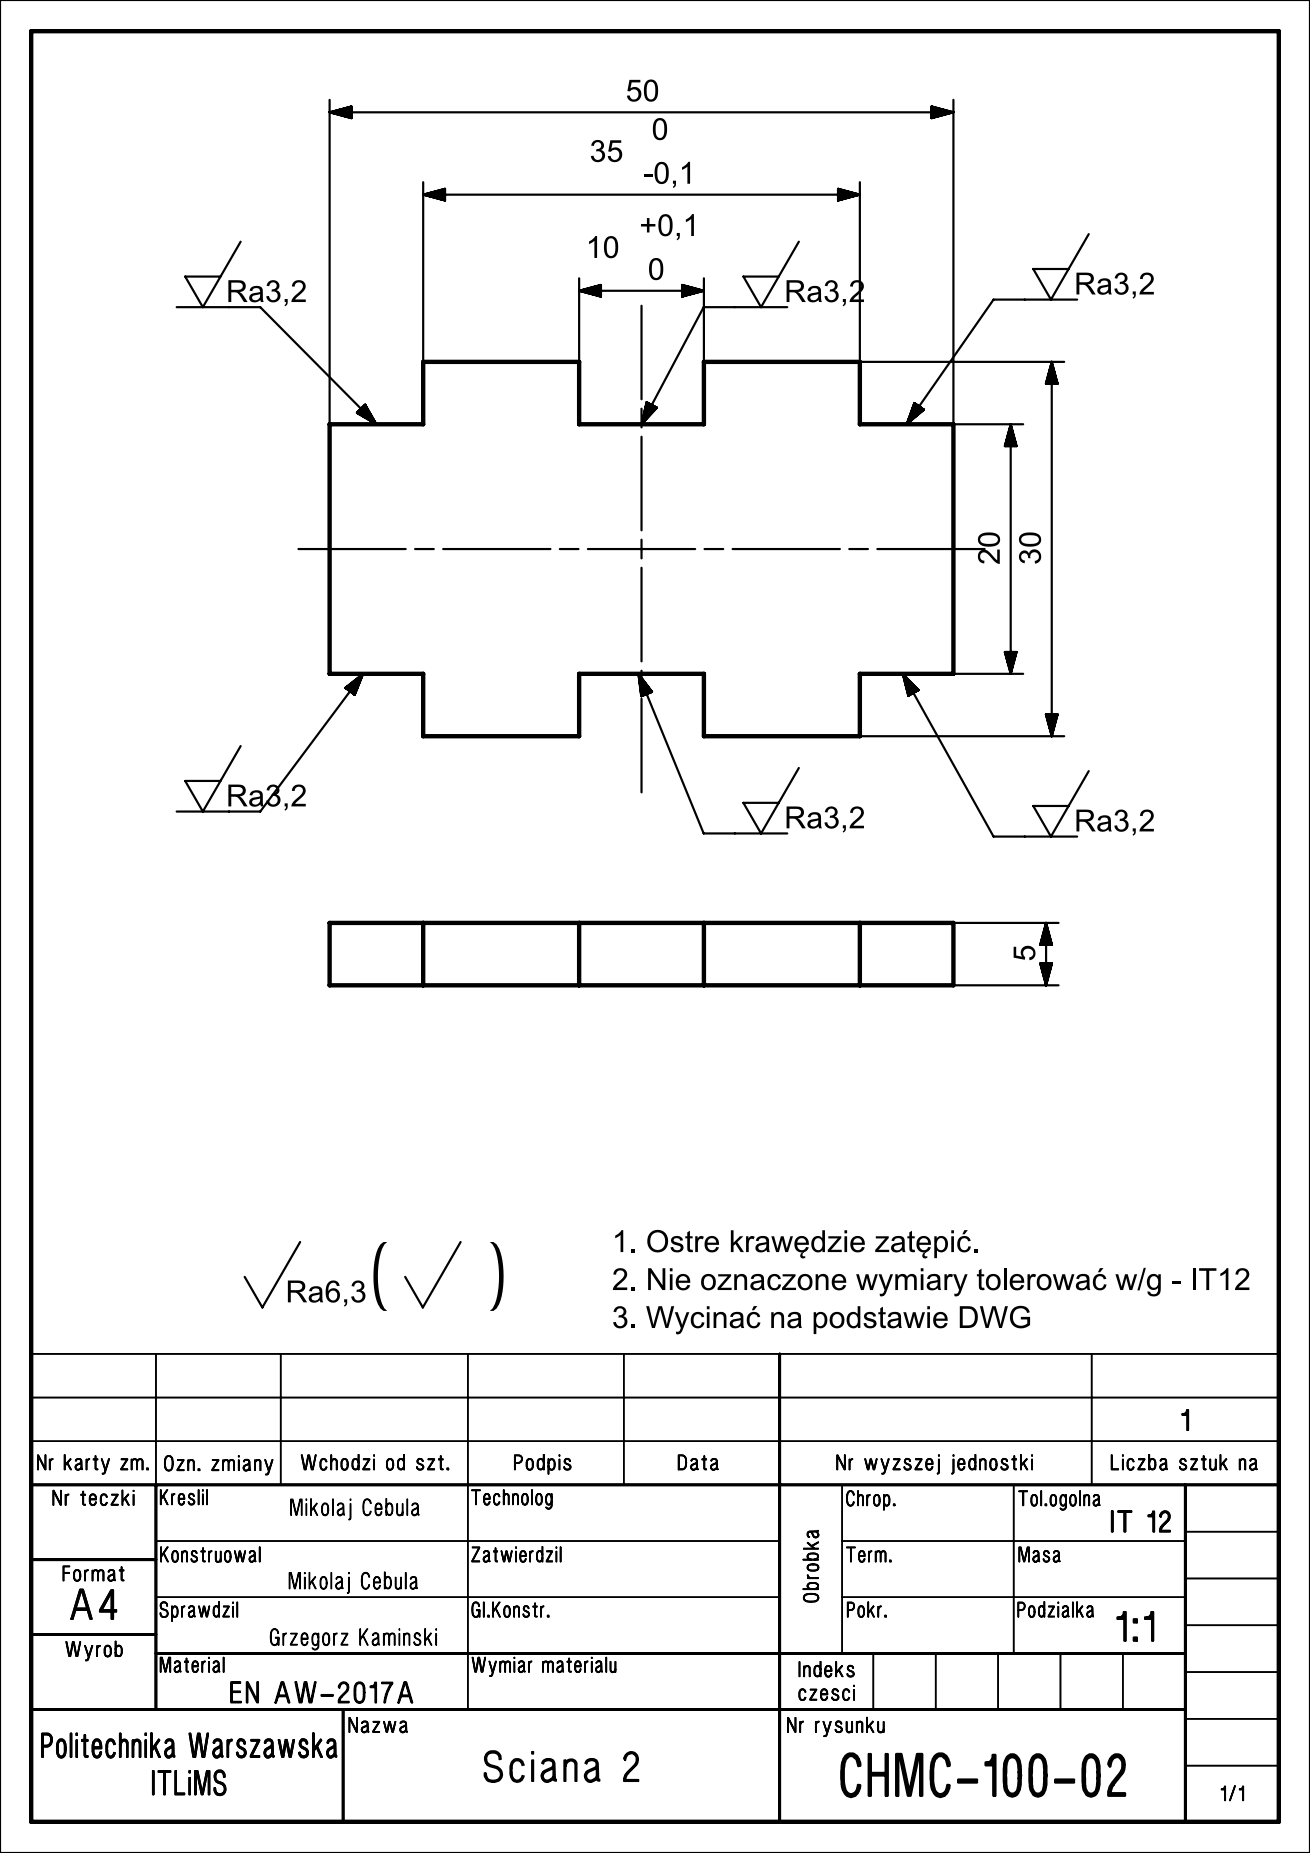
[picture p20: page 1]
