mikolajcebula/chwytak-robot/rysunki/CHMC-100-03.pdf

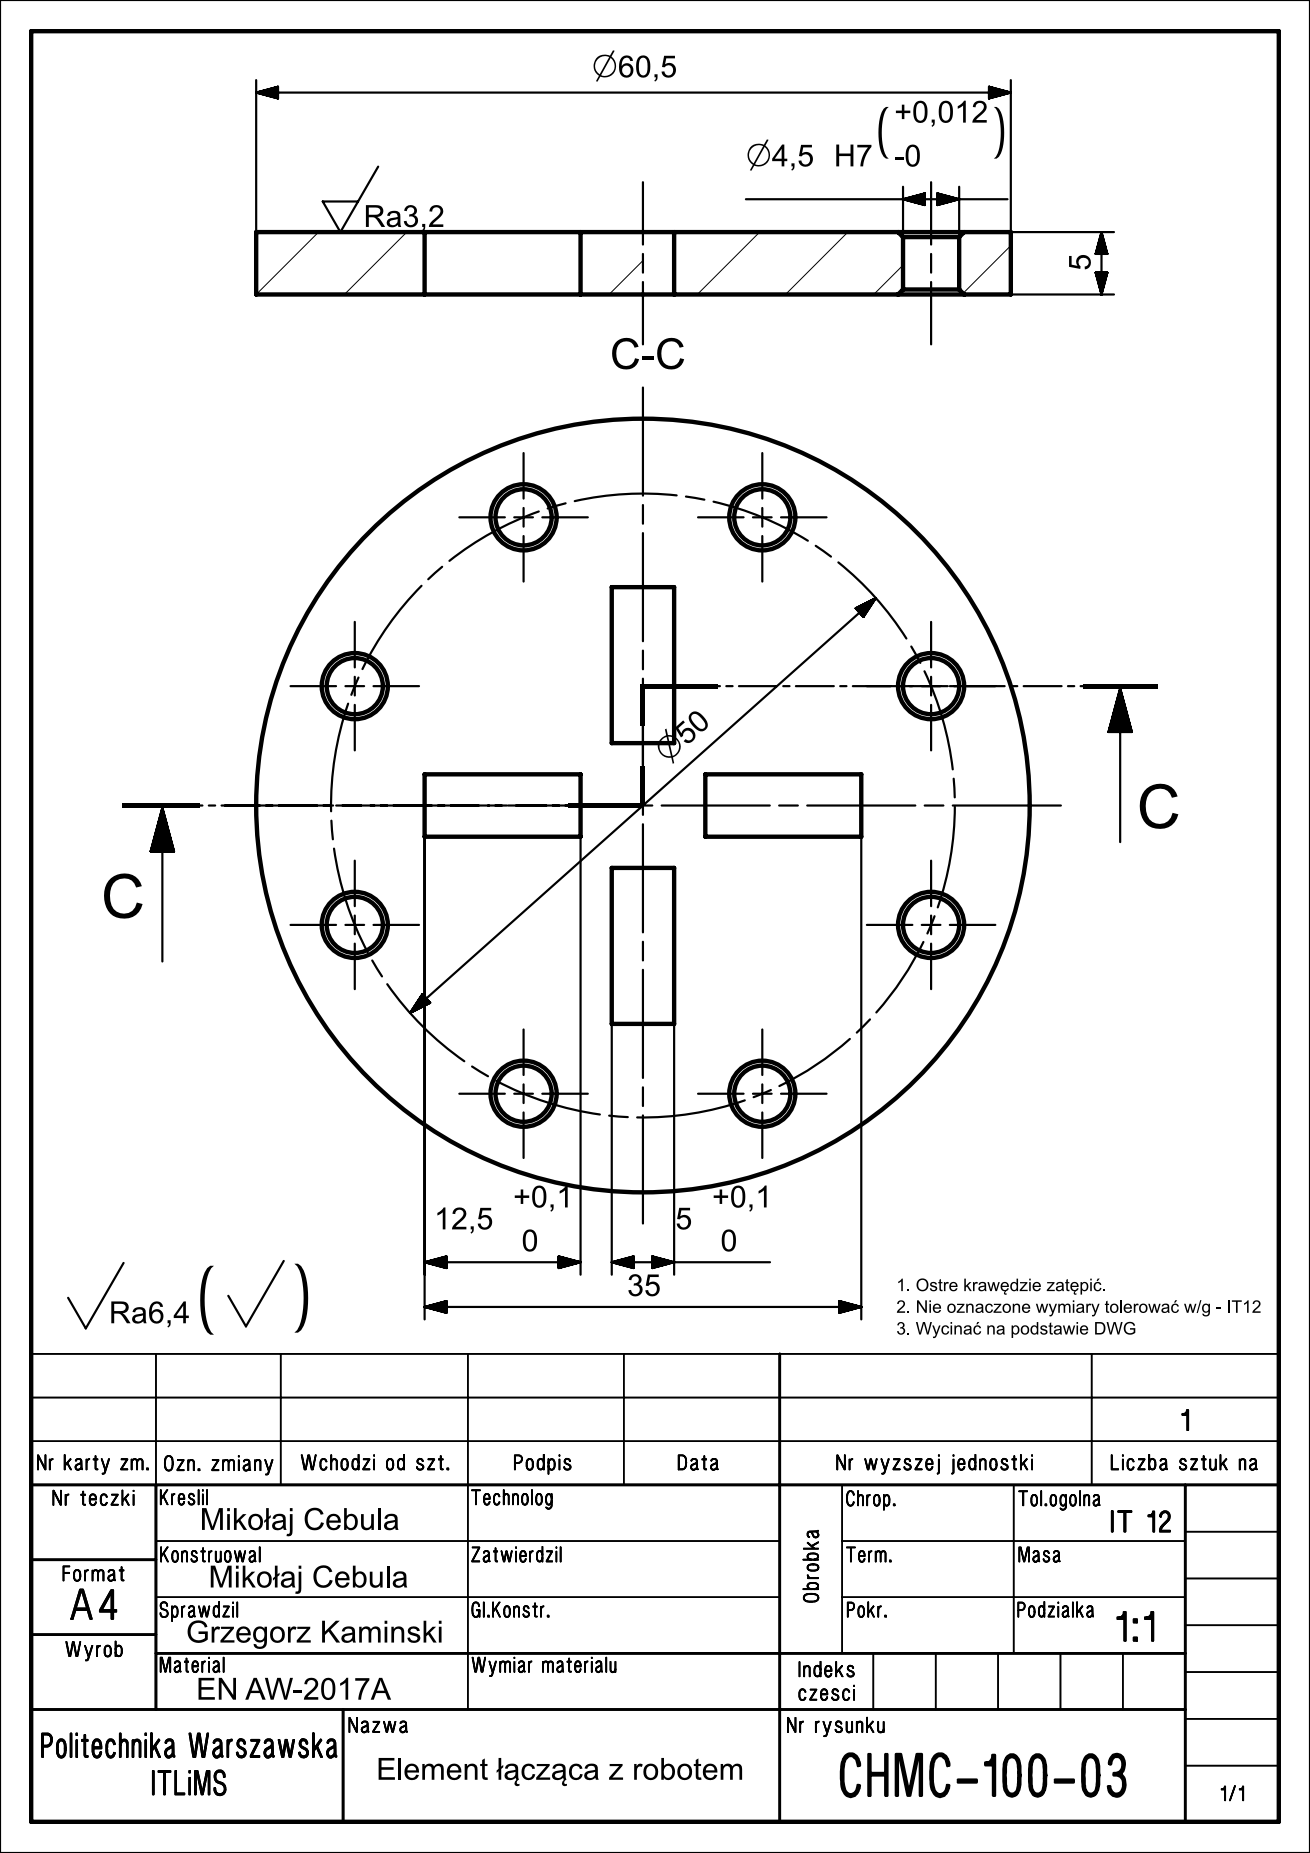
[picture p21: page 1]
