mikolajcebula/chwytak-robot/rysunki/CHMC-100-04.pdf

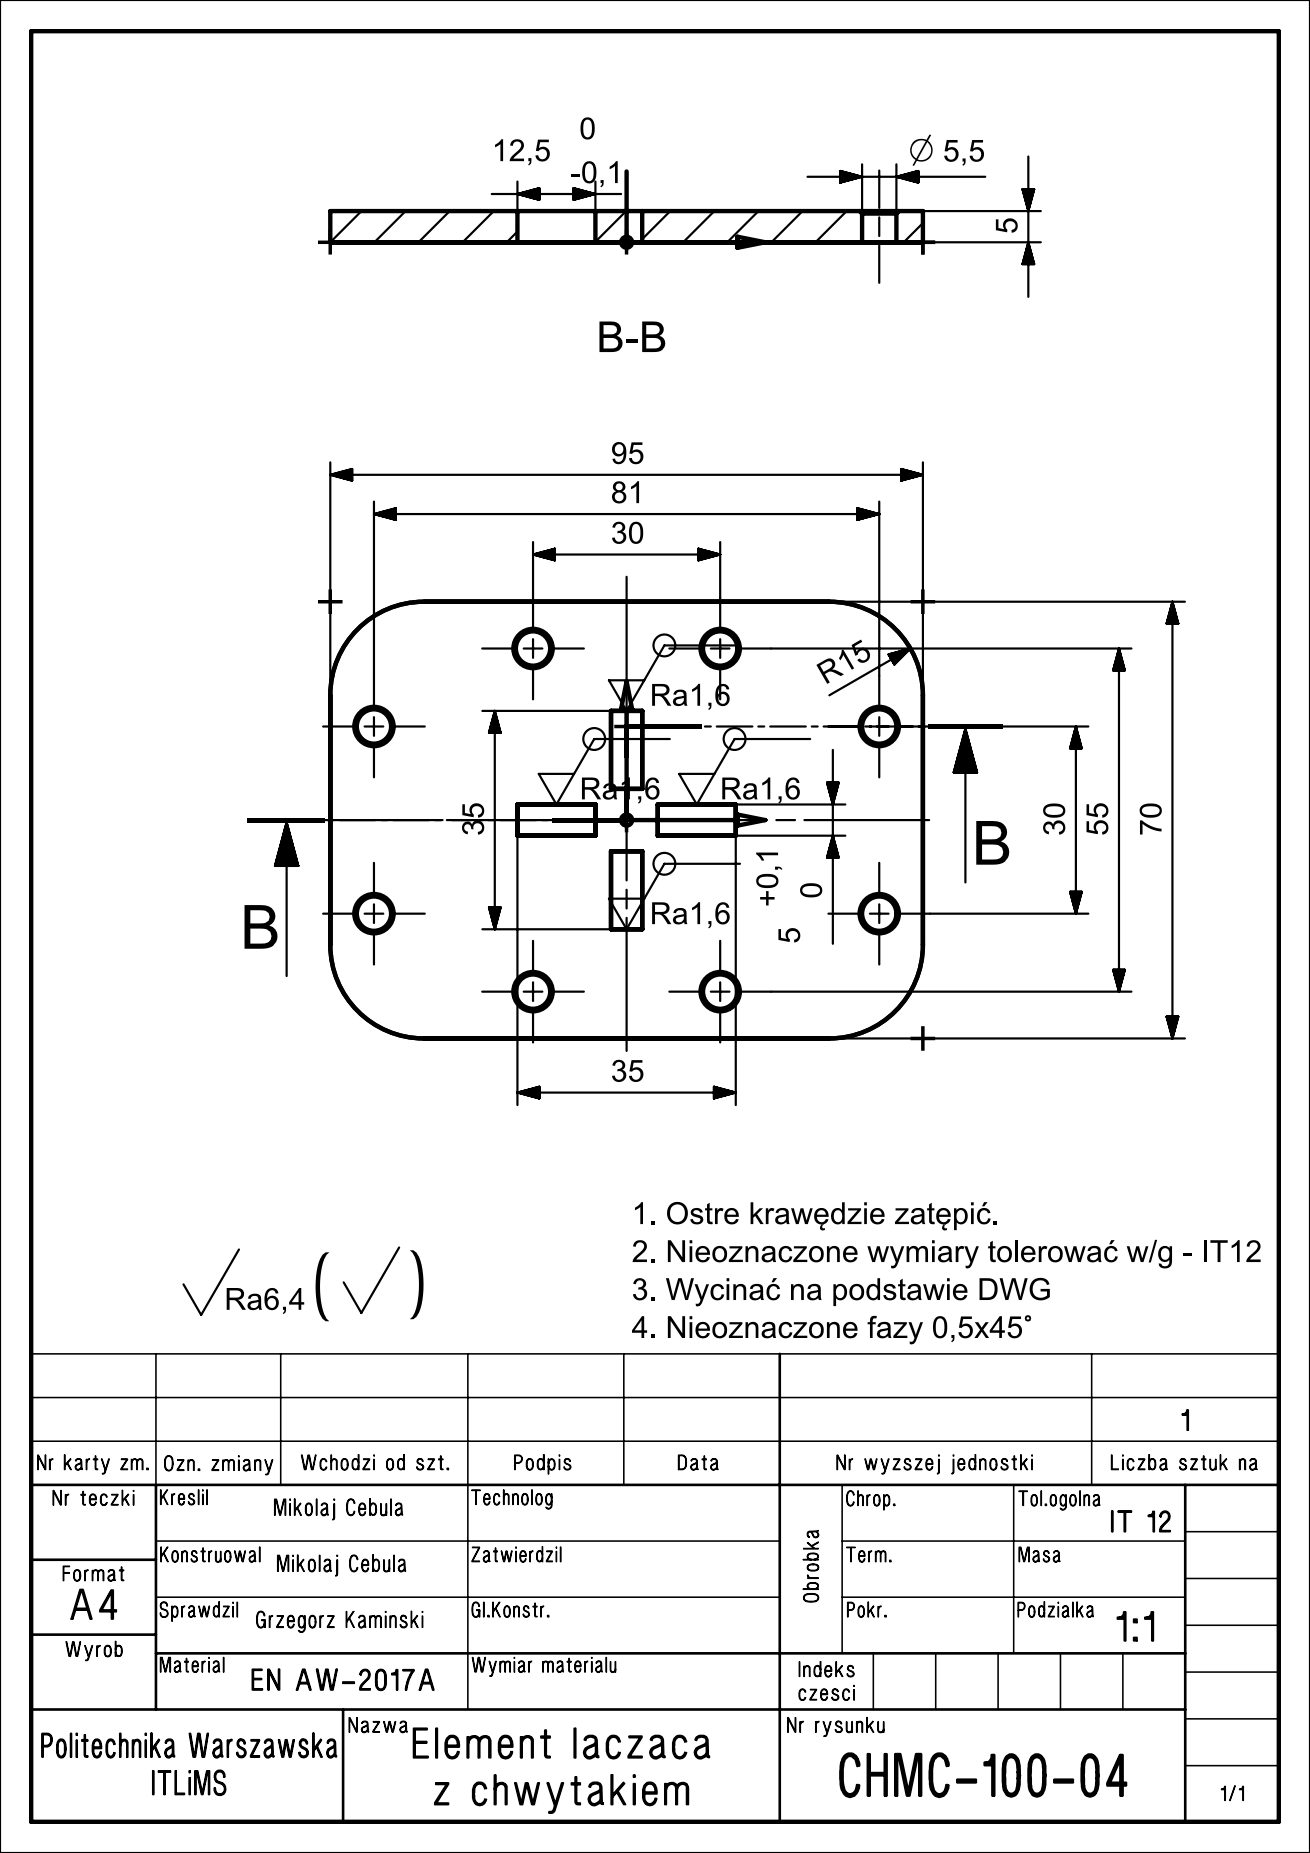
[picture p22: page 1]
