mikolajcebula/chwytak-robot/rysunki/CHMC-300-02.pdf

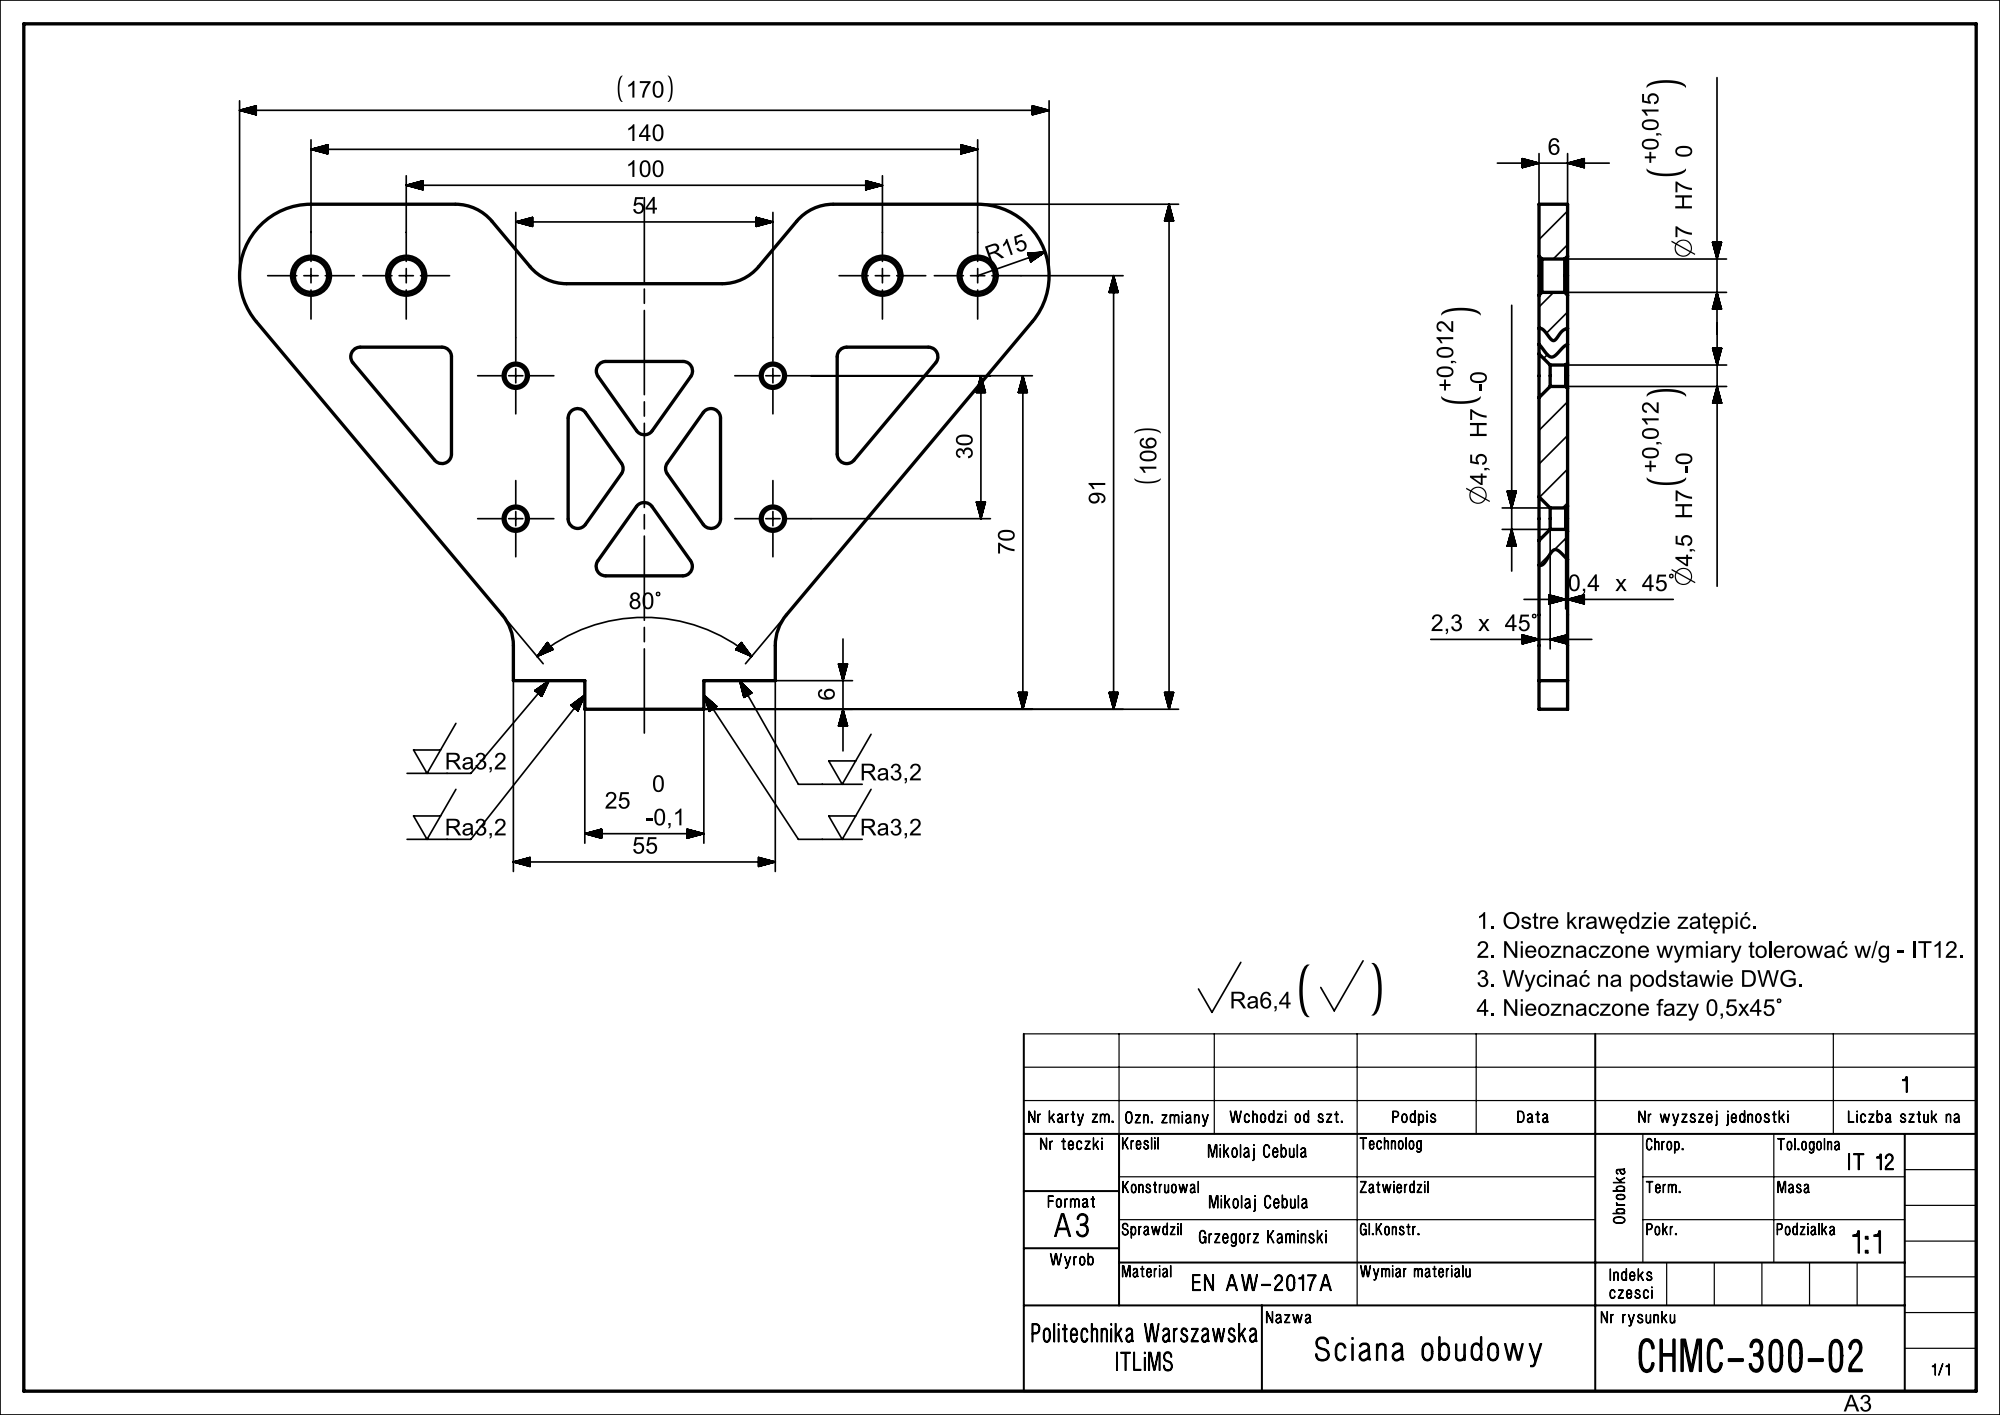
[picture p23: page 1]
