mikolajcebula/chwytak-robot/Chwytak.stp

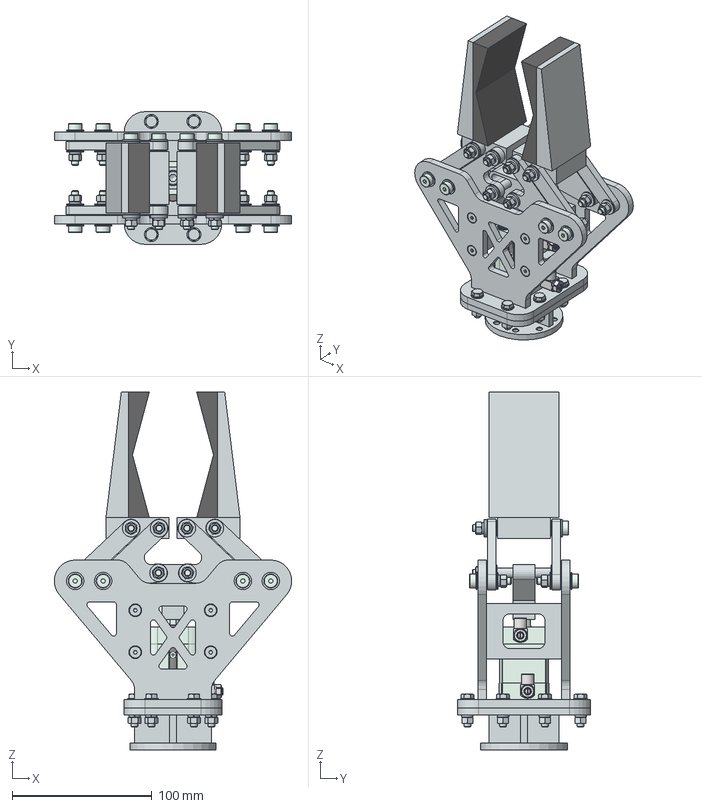
[picture p15: CAD file, 2022-02-08]
Chwytak.stp
170.0 x 95.0 x 256.2 mm
ISO_7089_m6 x 34
DIN_127_m5 x 22
ISO_4032_m5 x 22
CHMC-000-04 x 2
ISO_7089_m5 x 8
ISO_4017_m5_20 x 8
CHMC-100-04
CHMC-100-03
CHMC-100-02
CHMC-100-01 x 2
DIN_127_m6
ISO_4762_m6_25
ISO_10642_m5_30 x 4
ISO_7379_6_M5_55 x 6
ISO_7379_6_M5_16 x 8
ISO_10642_m6_25 x 4
CHMC-200-01 x 2
CHMC-200-02 x 2
CHMC-200-03 x 2
GFM-0607-17,5 x 4
GFM-0607-10 x 8
GFM-0607-029 x 56
CHMC-000-03
536233 ADN-15-PPS---(Z)
536233 ADN-15-PPS-I_(KS)
543861 SME-8M-DS-24V-K-0,3-M8D---(P)
151160 GRLA-M5-B x 2
ISO_10642_M4_12 x 8
CHMC-300-01 x 2
CHMC-300-03
CHMC-300-02 x 2
